fluffy/SprayWind/Arduino/WindSat2/schematic.pdf

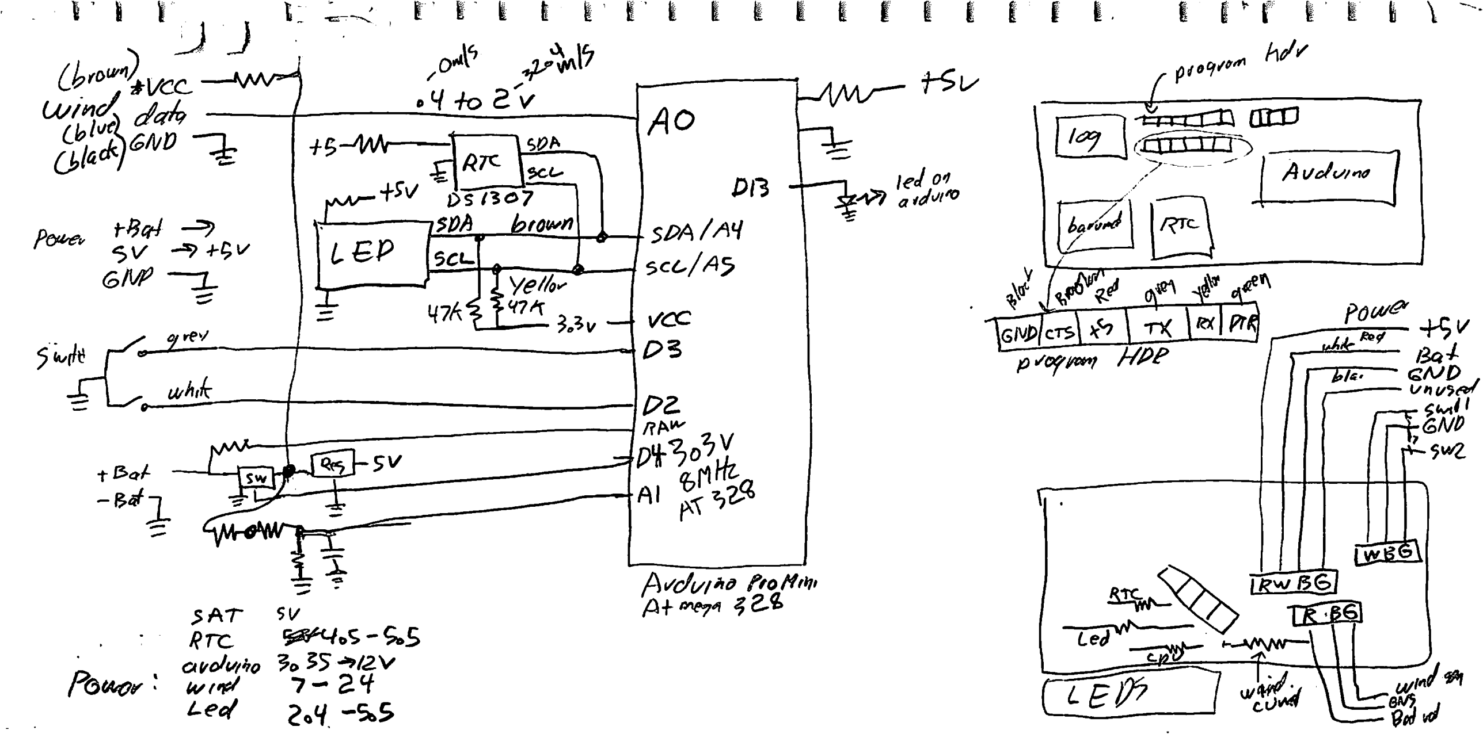
[picture p9: page 1]
