fluffy/SprayWind/doc/deploy.jpg

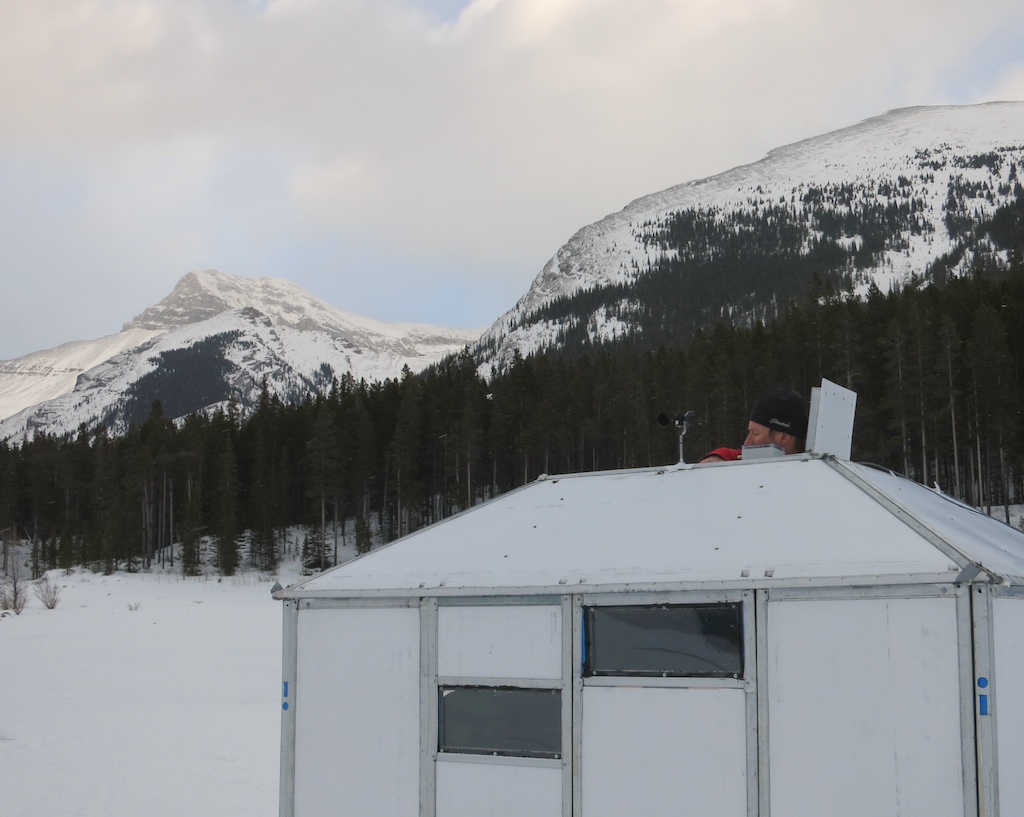
doc/deploy.jpg
