fluffy/SprayWind/wiring-notes.pdf

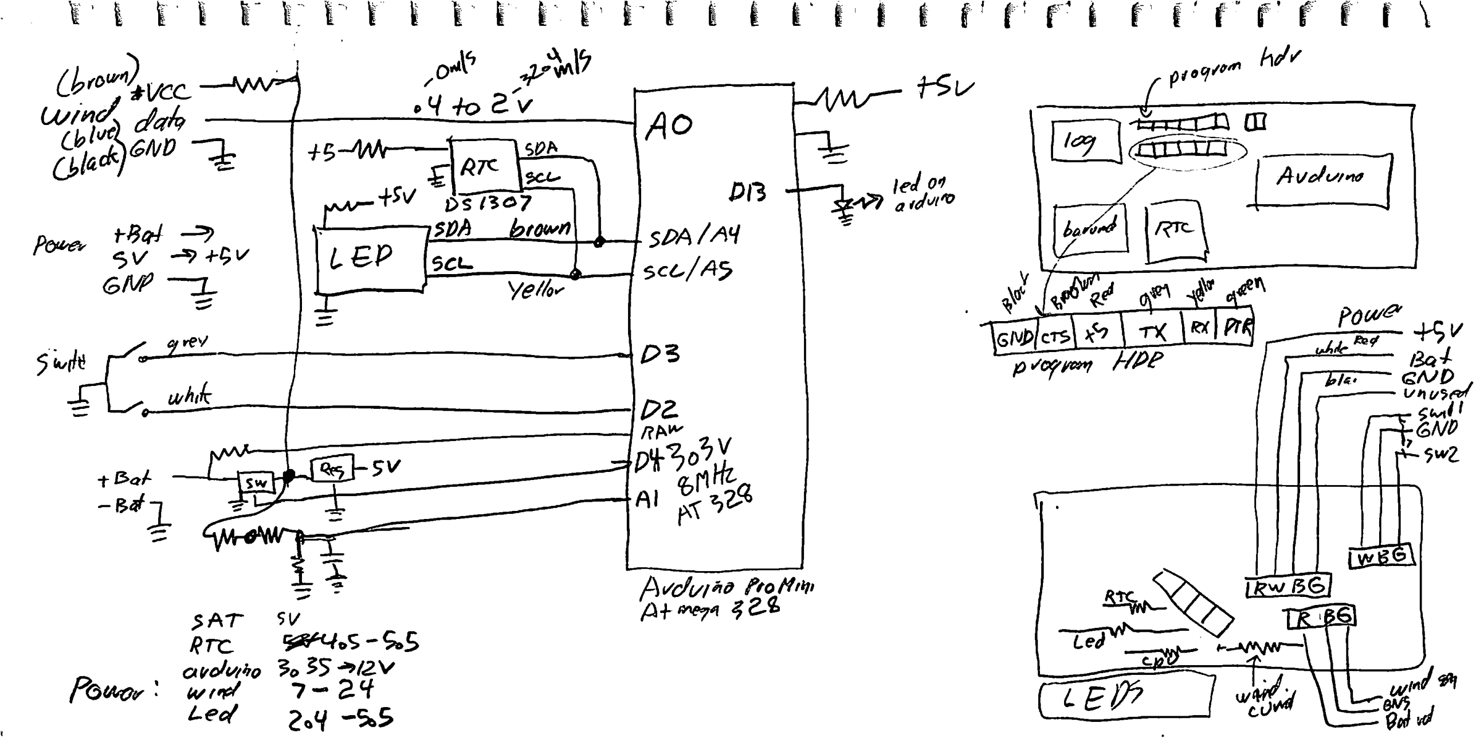
[picture p11: page 1]
