fluffy/SprayWind/website/testBody.txt

device_type=ROCKBLOCK&serial=8920&momsn=13&transmit_time=15-09-13+16%3A32%3A32&imei=300234063216600&iridium_latitude=51.0425&iridium_longitude=-114.0899&iridium_cep=5&data=7b22626e223a225242383932302f222c226275223a226d2f73222c2265223a5b7b226e223a2262617474657279222c2275223a2256222c2276223a342e337d2c7b226e223a2267757374222c2276223a31352e33347d2c7b226e223a2277696e64222c2276223a372e36377d5d7d
