fluffy/SprayWind/Arduino/WindSat/WindSat.ino

/* 
 Copyright (c) 2012, Cullen Jennings <fluffy@iii.ca> All rights reserved.
 
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
 1. Redistributions of source code must retain the above copyright notice, this
 list of conditions and the following disclaimer. 
 
 2. Redistributions in binary form must reproduce the above copyright notice,
 this list of conditions and the following disclaimer in the documentation
 and/or other materials provided with the distribution. 
 
 3. Neither the name of Cullen Jennings nor the names of its contributors may 
 be used to endorse or promote products derived from this software without 
 specific prior written permission.
 
 THIS SOFTWARE IS PROVIDED BY THE COPYRIGHT HOLDERS AND CONTRIBUTORS "AS IS" AND
 ANY EXPRESS OR IMPLIED WARRANTIES, INCLUDING,::w BUT NOT LIMITED TO, THE IMPLIED
 WARRANTIES OF MERCHANTABILITY AND FITNESS FOR A PARTICULAR PURPOSE ARE
 DISCLAIMED. IN NO EVENT SHALL THE COPYRIGHT OWNER OR CONTRIBUTORS BE LIABLE FOR
 ANY DIRECT, INDIRECT, INCIDENTAL, SPECIAL, EXEMPLARY, OR CONSEQUENTIAL DAMAGES
 (INCLUDING, BUT NOT LIMITED TO, PROCUREMENT OF SUBSTITUTE GOODS OR SERVICES;
 LOSS OF USE, DATA, OR PROFITS; OR BUSINESS INTERRUPTION) HOWEVER CAUSED AND
 ON ANY THEORY OF LIABILITY, WHETHER IN CONTRACT, STRICT LIABILITY, OR TORT
 (INCLUDING NEGLIGENCE OR OTHERWISE) ARISING IN ANY WAY OUT OF THE USE OF THIS
 SOFTWARE, EVEN IF ADVISED OF THE POSSIBILITY OF SUCH DAMAGE.
 
 
 Example program to connect up SPOT Connect to Arduino using the SparkFun Run SPOT Run board. 
 
 The source code repository for this project is at: https://github.com/fluffy/SprayWind 
 
 Using this Library:
 
 You have to set up a soft or hardware serial interface to the SPOT and it must be 115200 baud. 
 The SatConnect calss also takes the two pins to controll the power and on button to the Run SPOT Run board. 
 
 begin and end method turn the power on and off on the spot 
 write sends a message. It must be shorter than 41 bytes 
 
 you can use ready to find out when it is OK to do a write 
 
 you can use state to track the transmition of a message which takes aproximately 20 minutes 
 */

#include <Serial.h>
#define ONEWIRE_CRC16 0
#define ONEWIRE_CRC8_TABLE 0
#include <OneWire.h>

#define DEBUG( X ) Serial.println( X ); Serial2.println( X ); 
#define DEBUG_NOCR( X ) Serial.print( X ); Serial2.print( X ); 
#define DEBUG_NOCR2( X,Y ) Serial.print( X,Y );Serial2.print( X,Y ); 
#define DEBUG2( X, Y ) Serial.print( X ); Serial.println( Y ); Serial2.print( X ); Serial2.println( Y ); 

const int windPin = 2;     // the number of the wind speed pin - must be 2 for interupt 0 
const int batteryPin = 1;  // analog pin for battery voltage sense 
const int spotPowerPin = 6; /* PwrPin - turns on power to SPOT device */

const int spotOnPin = 7;  /* controlls the "on" button on the SPOT to turn the device on and off  */




// ========================================================================
// Stuff for Spot Connect Satellite code 

class SatConnect
{
public:
  SatConnect( Stream& pSerial, int pPwrPin, int pOnPin ); 

  enum SatConnectState 
  { 
    off,  poweringUp, readyToSend, haveMsgToSend, findingPostion, sending, sentOnce, sentTwice, errorNoGPS, errorNoSpot
  };

  bool ready();
  SatConnectState state();
  void begin();
  void end();

  void write( char* msg, int len );

private:
  const int pwrPin;
  const int onPin;
  Stream& serial;
  SatConnect::SatConnectState s; 
};


SatConnect::SatConnect( Stream& pSerial, int pPwrPin, int pOnPin ): 
serial(pSerial), pwrPin(pPwrPin), onPin(pOnPin)
{
  pinMode(pwrPin,OUTPUT);
  pinMode(onPin,OUTPUT);
  digitalWrite( pwrPin, LOW ); // turn off power to SPOT
  digitalWrite( pwrPin, HIGH ); // Leave button not pushed 
  s = SatConnect::off;
}


bool SatConnect::ready()
{
  if ( state() == SatConnect::readyToSend ) 
  {
    return true;
  }
  return false;
}


SatConnect::SatConnectState SatConnect::state()
{
  static unsigned long satLastTime=0;

  if ( s == SatConnect::off )
  {
    return s;
  }

#if 0  // can skip this and be more agresive about error recoevery
  if ( s == SatConnect::errorNoSpot )
  {
    return s;
  }
#endif

  unsigned long now =  millis();
  if ( now < satLastTime + 500 ) // if state if less than 500 ms old, don't check for new state 
  { 
    return s;
  }
  satLastTime = now;

  // flush out any old stuff in serial buffer   
  unsigned long lastTime = millis();
  uint8_t c;
  do
  {
    if ( serial.available() )
    {
      c = serial.read();
      lastTime = millis();
      DEBUG2("Flushing extra data: 0x", HEX ); 
    }
  } 
  while ( millis() < lastTime + 150 ); // no data for 150 ms 

  static uint8_t statReq[3] = {  
    0xAA, 0x03, 0x52                                             };
  serial.write( statReq, sizeof( statReq ) );

  lastTime = millis();
  uint8_t buf[ 0x30 ];
  buf[0] = 0;
  buf[1] = sizeof(buf);
  buf[7] = 0;
  buf[19]= 0;
  int i=0;
  do
  {
    if ( serial.available() )
    {
      buf[i++] = serial.read();
      lastTime = millis();
    }
    if (buf[0] != 0xAA) // keep reading until find the 0xAA start of message byte 
    {
      i=0;
    }
    if ( i == buf[1] )
    {
      //DEBUG( "Read full packet" );
      break;
    }
  } 
  while ( (millis() < lastTime + 150) && ( i < sizeof(buf) ) ); // 150 ms timeout after last char read 

  if ( (i != buf[1]) && (i+2 != buf[1]) ) // for some reason always getting 2 bytes short on some firware
  {
    int timeout = millis()-lastTime;
    DEBUG( "Problem reading packet buf" );
    DEBUG2( "buf[1]=", buf[1] );
    DEBUG2( "i=", i );
    DEBUG2( "time out=", timeout );
  }

#if 1
  //DEBUG2( "i= 0x" ); 
  //DEBUG( i , HEX );
  DEBUG_NOCR( "SPOT Status: " );
  for ( int j=0; j<i; j++ )
  {
    int v=buf[j];
    DEBUG_NOCR2(v/16, HEX);
    DEBUG_NOCR2(v%16, HEX);
    DEBUG_NOCR(" ");
  }
  DEBUG(" ");
#endif


  if ( buf[0] != 0xAA )
  {
    DEBUG("put in errorNoSpot in state() call" );
    s = SatConnect::errorNoSpot;
    return s;
  }

  DEBUG2( "spot status=" , buf[7] );
  DEBUG2( "gps found=" , buf[26] );
  DEBUG2( "num satellite=" , buf[31] );

  if ( buf[7] == 7 )
  {
    s = SatConnect::findingPostion;
  }

  if ( buf[7] == 15 )
  {
    s = SatConnect::sending;
  }

  if ( buf[7] == 6 )
  {
    s = SatConnect::sending;
    if ( buf[19] == 1 )
    {
      s = SatConnect::sentOnce;
    }
    if ( buf[19] == 2 )
    {
      s = SatConnect::sentTwice;
    }
  }

  // TODO - detect error no GPS 
  if ( buf[7] == 0 )
  {
    s = SatConnect::readyToSend;
  }

  return s;
}


void SatConnect::begin()
{
  s = SatConnect::off;
  //serial.begin( 115200 ); // TODO - move to here ?

  DEBUG( "Starting up spot" );
  pinMode(pwrPin,OUTPUT);
  pinMode(onPin,OUTPUT);
  digitalWrite( pwrPin, LOW ); // turn off power to SPOT
  digitalWrite( onPin, HIGH ); // release the ON button for SPOT  
  delay( 1500 /* don't know how long this should be */ ); // wait for total power off for reset (500 seemed too low)
  //DEBUG( "  about to turn on power to spot" );
  digitalWrite( pwrPin, HIGH ); // turn on power to SPOT
  //DEBUG( "  power is on" );
  delay( 750 /* don't know how long this should be */ ); // wait for power to get stable 
  //DEBUG( "  turing on " );
  digitalWrite( onPin, LOW ); // press the ON button to power up SPOT
  delay( 4100 /* TODO - how long */ ); // wait for turn on and go into discovery mode TOOD - check if really need to go bluetooth discovery mode 
  //DEBUG( "  waiting to go on " );
  digitalWrite( onPin, HIGH ); // release the ON button for SPOT - it is still on 
  DEBUG( "   spot is on" );

  //unsigned long  startTime = millis();
  //unsigned long  charTime = millis();

  DEBUG( "Wait for SPOT self check and flush serial data" );
  DEBUG_NOCR( "Flush: " );
  unsigned long lastTime = millis();
  do
  {
    uint8_t c;
    if ( serial.available() )
    {
      c = serial.read();
      //charTime = millis();

      int v=c;
      DEBUG_NOCR2(v/16, HEX);
      DEBUG_NOCR2(v%16, HEX);
      DEBUG_NOCR(" ");
    }
  } 
  while ( millis() < lastTime+3000 ); // flush for at least 2.5 seconds 
  DEBUG( "  done flushing" );

  //DEBUG2( "flush time was " , charTime - startTime );

  s = SatConnect::poweringUp;   
}


void SatConnect::end()
{
  if ( s ==  SatConnect::off )
  {
    digitalWrite( pwrPin, LOW ); // turn off the power to SPOT
    delay( 1000 ); // make power stays off of a bit 
    return;  
  }

  DEBUG( "Shuting down spot" );
  digitalWrite( onPin, LOW ); // press the ON button to power off SPOT
  delay( 2200  );   // 1500 too short 
  DEBUG( "  waiting to go off " );
  digitalWrite( onPin, HIGH ); // release the ON button for SPOT - should be off now  
  delay( 1500 /* TODO - how long */ );   
  digitalWrite( pwrPin, LOW ); // turn off the power to SPOT
  delay( 1000 ); // make power stays off of a bit 

  s = SatConnect::off;
  DEBUG( "   spot is off" );
}


void  SatConnect::write( char* msg, int len )
{
  if ( state() == SatConnect::off ) 
  {
    begin(); // if not powered on, turn it on 
  }

  do 
  { 
    // wait until ready to send
  } 
  while ( !ready() );

  if ( len > 41 ) // TODO - figure out max len 
  {
    len = 41; 
  }

  // send message to SPOT 
  serial.flush();
  static uint8_t sendReq[8] = { 
    0xAA, 0x08, 0x26, 0x01, 0x00, 0x01, 0x00, 0x01                                             };
  sendReq[1] = sizeof(sendReq) + len; // set the length of the message 
  serial.write( sendReq, sizeof( sendReq ) );
  serial.write( (uint8_t*)msg, len );

  unsigned long lastTime = millis();
  uint8_t buf[ 0x30 ];
  buf[0] = 0;
  buf[1] = sizeof(buf);
  int i=0;
  do
  {
    if ( serial.available() )
    {
      buf[i++] = serial.read();
    }
    if ( i == buf[1] )
    {
      //DEBUG( "Read full packet" );
      break;
    }
  } 
  while ( (millis() < lastTime + 500) && ( i < sizeof(buf) ) ); // 500 ms timeout after reqest sent 

  if ( i != buf[1] )
  {
    int timeout = millis()-lastTime;
    DEBUG( "Problem reading packet buf after write" );
    DEBUG2( "buf[1]=", buf[1] );
    DEBUG2( "i=", i );
    DEBUG2( "time out=", timeout );
  }

#if 1
  //DEBUG2( "i=" , i );
  DEBUG_NOCR( "SPOT data after write: " );
  for ( int j=0; j<i; j++ )
  {
    int v=buf[j];
    DEBUG_NOCR2(v/16, HEX);
    DEBUG_NOCR2(v%16, HEX);
    DEBUG_NOCR(" ");
  }
  DEBUG(" ");
#endif

  s = SatConnect::haveMsgToSend;
}


SatConnect satConnect( Serial3, spotPowerPin, spotOnPin ); 

// =================================================================
// stuff for wind 

volatile unsigned long windCount; // count of revolutions of wind sensor 
unsigned long windStartTime;
unsigned long windPrevTime;
unsigned long windStartCount;
unsigned long windPrevCount;
unsigned int  minMetersPer10s=0;
unsigned int  curMetersPer10s=0;
unsigned int  maxMetersPer10s=0;
unsigned int  avgMetersPer10s=0;


void incWindCount()
{
  // this is the itnerupt handler and interupts are disabled in it
  windCount++; 
}


unsigned long getWindCount()
{
  unsigned long r;
  noInterrupts(); // disable interupts while copying the counter 
  r = windCount;
  interrupts();
  return r; 
}


void resetWind()
{
  unsigned long time = millis();
  unsigned long count = getWindCount();

  windStartTime = time;
  windPrevTime = time;
  windStartCount = count;
  windPrevCount = count; 

  minMetersPer10s = 0xFFFF;
  maxMetersPer10s = 0;
}


void updateWind()
{
  unsigned long time = millis();

  if ( time < windPrevTime + 10000 ) // wait at least 10 seconds
  {
    return;
  }
  unsigned long count = getWindCount();

  unsigned long dTime = time - windPrevTime;
  unsigned long dCount = count - windPrevCount;
  unsigned long dMeters = (int)dCount + ( (int)dCount / 8 ); // sketchy conversion that looks about right 
  curMetersPer10s = dMeters * 10000 / (int)dTime ;  // 10000 is 10 secons and 1000 to move time from ms to s

  if ( curMetersPer10s > maxMetersPer10s ) maxMetersPer10s = curMetersPer10s;
  if ( curMetersPer10s < minMetersPer10s ) minMetersPer10s = curMetersPer10s;

  //DEBUG2( "dTime = " , dTime );

  //DEBUG2( "dCount = " , dCount );

  //DEBUG2( "Current = " , curMetersPer10s );

  dTime = (time - windStartTime) / 100; // in 10th of seconds 
  dCount = count - windStartCount;
  unsigned long avgCountPer10s =  dCount*100 / dTime; // 100 is 10 for per 10 seconds , and 10 for time is in 10ths of seconds
  avgMetersPer10s = (int)avgCountPer10s + ( (int)avgCountPer10s / 8 ); // sketchy conversion that looks about right 

  //DEBUG2( "Avg = " ); 
  //DEBUG( avgMetersPer10s );

  windPrevTime = time;
  windPrevCount = count;
}


//===============================================================================
// Stuff for battery 

unsigned int voltageX100=0;

void updateBattery()
{
  int v = analogRead( batteryPin ); // 0-5 v scaled to 0-1023 

  //voltageX100 = 80 + v + (v>>1) + (v>>5); // this is when power goes thgrough diode 
  voltageX100 = v + (v>>1) + (v>>5); 
}


// ===============================================================================
// Stuff for temperature   

int          tempatureX10=0; 
typedef uint8_t DeviceAddr[8];
DeviceAddr tempatureAddr;
char tempatureType='-';
OneWire  oneWireBus(10); // using digiital IO on pin 10


void copyAddr( uint8_t src[], uint8_t dst[] )
{
  for( int i=0; i<8; i++ )
  {
    dst[i]=src[i];
  }
}

// #define FAST_TEMP_CONV

void setupTemp()
{
  tempatureX10 = 0;

  DEBUG("Scanning 1-wire Bus A ...");
  DeviceAddr addr;
  oneWireBus.reset_search();
  while ( oneWireBus.search(addr) )
  {
    if ( OneWire::crc8( addr, 7) != addr[7]) 
    {
      DEBUG("1-Wire BAD-CRC2");
    }
    else
    {
      if ( addr[0] == 0x10 ) 
      {
        DEBUG("Found DS18S20 Temperature on bus A");
        copyAddr( addr, tempatureAddr);   
        tempatureType = 'S';   
      }
      else if ( addr[0] == 0x28 ) 
      {
        DEBUG("Found DS18B20 Temperature on bus A");
        copyAddr( addr, tempatureAddr);   
        tempatureType = 'B';   
      }
      else
      {
        DEBUG2("Found 1-wire device of unknown address type: ",  addr[0] );
      }
    }
  }

  if ( tempatureType == 'B' )
  {
    // program for fast or slow conversions 
    oneWireBus.reset();
    oneWireBus.select(tempatureAddr);
    oneWireBus.write(0x4E,1);  // Program config register
    oneWireBus.write(0x0,1);
    oneWireBus.write(0x0,1);
#ifdef  FAST_TEMP_CONV
    oneWireBus.write(0x1F,1);
#else
    oneWireBus.write(0x7F,1);
#endif
  }

}


void updateTemp( )
{
  oneWireBus.reset();
  oneWireBus.select(tempatureAddr);
  oneWireBus.write(0x44,1);  // do conversion 

  if (tempatureType =='B' )
  {
#ifdef FAST_TEMP_CONV
    delay(100);
#else
    delay(800);  // at least 750 ms for conversion time   
#endif
  }
  else
  {
    delay(800);  // at least 750 ms for conversion time   
  }
  oneWireBus.reset();
  oneWireBus.select(tempatureAddr);    
  oneWireBus.write(0xBE);  // read results

  byte data[9];
  for ( int i = 0; i < 9; i++) 
  {          
    data[i] = oneWireBus.read();
  }
  if ( OneWire::crc8( data, 8) != data[8] )
  {
    DEBUG("Tempature BAD-CRC");
    tempatureX10 = 0;
    return ; 
  }

  int tempatureX100 =0;
  tempatureX10 =0;

  if (tempatureType =='B' )
  {
    //DEBUG_NOCR( "config reg = 0x" );
    //DEBUG_NOCR2( data[4],HEX );
    //DEBUG(" ");
#ifdef   FAST_TEMP_CONV
    data[0] = data[0] & 0xF8;
#endif

    int temp16x = (data[1]<<8) + data[0];    
    tempatureX100 = (temp16x*25) / 4; 
    tempatureX10 = (temp16x*5) / 8;
  }
  else if (tempatureType =='S' )
  {
    int temp2x = (data[1]<<8) + data[0];    
    //DEBUG2( "count remain = " , data[6] );
    int temp16x = ( temp2x & 0xFFFE )*8 - 4 + 16 - data[6];

    tempatureX100 = (temp16x*25) / 4; 
    tempatureX10 = temp16x * 5 / 8;
  }

  //DEBUG_NOCR( "Temp data = 0x" );
  //DEBUG_NOCR2( data[1], HEX );
  //DEBUG_NOCR( " " );
  //DEBUG_NOCR2( data[0], HEX );
  DEBUG2( " Got tempature 10x = " , tempatureX10 );

  //DEBUG2( " Got tempature 100x = " , tempatureX100 );
}


// ========================================================================
// stuff to form the output JSON sent over SPOT 

char  outputVector[41];
void formatOutputVector()
{
  int i=0;
  outputVector[i++] = '{';
  outputVector[i++] = '"';
  outputVector[i++] = 'v';
  outputVector[i++] = '"';
  outputVector[i++] = ':';
  outputVector[i++] = '[';

  outputVector[i++] = '0' + (curMetersPer10s/100)%10;
  if  (outputVector[i-1] == '0' ) outputVector[i-1]=' ';
  outputVector[i++] = '0' + (curMetersPer10s/10 )%10;
  outputVector[i++] = '.';
  outputVector[i++] = '0' + (curMetersPer10s    )%10;
  outputVector[i++] = ',';

  outputVector[i++] = '0' + (minMetersPer10s/100)%10;
  if  (outputVector[i-1] == '0' ) outputVector[i-1]=' ';
  outputVector[i++] = '0' + (minMetersPer10s/10 )%10;
  outputVector[i++] = '.';
  outputVector[i++] = '0' + (minMetersPer10s    )%10;
  outputVector[i++] = ',';

  outputVector[i++] = '0' + (avgMetersPer10s/100)%10;
  if  (outputVector[i-1] == '0' ) outputVector[i-1]=' ';
  outputVector[i++] = '0' + (avgMetersPer10s/10 )%10;
  outputVector[i++] = '.';
  outputVector[i++] = '0' + (avgMetersPer10s    )%10;
  outputVector[i++] = ',';

  outputVector[i++] = '0' + (maxMetersPer10s/100)%10;
  if  (outputVector[i-1] == '0' ) outputVector[i-1]=' ';
  outputVector[i++] = '0' + (maxMetersPer10s/10 )%10;
  outputVector[i++] = '.';
  outputVector[i++] = '0' + (maxMetersPer10s    )%10;
  outputVector[i++] = ',';

  // output tempature in degC  
  int v = (tempatureX10>=0) ? tempatureX10 : -tempatureX10;
  outputVector[i++] = (tempatureX10>0) ? ' ' : '-';
  outputVector[i++] = '0' + (v/100)%10;
  if  (outputVector[i-1] == '0' ) 
  {
    outputVector[i-1]= (tempatureX10>=0) ? ' ' : '-';
    outputVector[i-2]= ' ';
  }
  outputVector[i++] = '0' + (v/10 )%10;
  outputVector[i++] = '.';
  outputVector[i++] = '0' + (v    )%10;
  outputVector[i++] = ',';

  // output battery voltage voltageX100
  outputVector[i++] = '0' + (voltageX100/1000)%10;
  if  (outputVector[i-1] == '0' ) outputVector[i-1]=' ';
  outputVector[i++] = '0' + (voltageX100/100  )%10;
  outputVector[i++] = '.';
  outputVector[i++] = '0' + (voltageX100/10   )%10;
  outputVector[i++] = '0' + (voltageX100      )%10;
  //outputVector[i++] = ',';

  outputVector[i++] = ']';
  outputVector[i++] = '}';
  outputVector[i++] = 0;
  if (i >= sizeof(outputVector) )
  {
    DEBUG("buffer overlow in format output vector");
    DEBUG2( "i=" , i );
    while (1);
  }
}



//=====================================================================
// main program part 

void setup()
{
  Serial.begin(19200); 
  Serial2.begin(19200); 
  Serial3.begin(115200); // important - don't forget to setup the serial connection speed to the spot 

  delay( 1500 ); 
  DEBUG("Starting program - Version 0.1.2");

  // setup wind 
  pinMode(windPin, INPUT);
  windCount = 0;
  attachInterrupt(0, incWindCount, RISING); // int 0 is digital pin 2 
  resetWind();

  // set up battery 
  analogReference( DEFAULT );

  // set up temperature on oneWire 
  setupTemp();
}


void loop()
{
  static bool sendNow = true;
  static unsigned long prevLoopTime=0;
  static unsigned long satOnTime=0;
  unsigned long thisLoopTime=0;

  thisLoopTime = millis();

  unsigned long thisHour = prevLoopTime / 3600000;
  unsigned long prevHour = thisLoopTime / 3600000;

  // every hour, send a new report
  if ( thisHour != prevHour )
  {
    sendNow = true; 
  }

#if 0  // don't do this and try and receover from error  
  // if the spot has and error, shut it down 
  if ( satConnect.state() == SatConnect::errorNoSpot )
  {
    DEBUG( "turned off sat due to error" );
    satConnect.end(); // turn power to spot off 
    sendNow = false; // if msg to be sent, wait till next hour
  }
#endif 

  // if sat has been on for more than 30 minutes, turn it offf 
  if ( (satConnect.state() != SatConnect::off) && ( thisLoopTime > satOnTime+1800000 ) ) 
  {
    DEBUG( "turned off sat due to being on too long" );
    satConnect.end(); // turn power to spot off 
    sendNow = false; // if msg to be sent, wait till next hour
  }

#if 0
  sendNow = false;
#endif

  // if message to send,
  if (sendNow)
  {
    if (  millis() > 30000  )  // if message to send, and arduino has been up for at least 30 seconds, turn on the spot
    {
      if ( satConnect.state() == SatConnect::off  )
      {
        DEBUG( "turned on sat because have messages to send" );
        satConnect.begin(); // turn spot power on
        satOnTime = millis();
      }
    }
  }

  if (sendNow)
  {
    if ( satConnect.ready()  )
    {
      updateBattery();
      updateTemp();
      updateWind();

      formatOutputVector();

      resetWind();

      DEBUG2("Sending Message len=", strlen(outputVector) ); 
      DEBUG2("msg=", outputVector );

      satConnect.write( outputVector, strlen(outputVector) );
      sendNow = false;
    }
  }

#if 0 // TODO remove 
  if ( sendNow == false )
  { 
    if ( satConnect.state() == SatConnect::sentTwice)
    {
      DEBUG( "Turning off sat because have sent the message once" );
      satConnect.end(); // turn power to spot off 
      sendNow = true;
    }
  }
#endif  

  if ( sendNow == false )
  { 
    if ( satConnect.ready() )
    {
      DEBUG( "Turning off sat because done sending messages" );
      satConnect.end(); // turn power to spot off 
    }
  }

#if 1
  unsigned long thisFifteenSec = prevLoopTime / 15000;
  unsigned long prevFifteenSec = thisLoopTime / 15000;
  if ( thisFifteenSec != prevFifteenSec ) // print out status ever 15 seconds 
  {
    int state = int( satConnect.state() );
    unsigned long time =  millis();

    DEBUG_NOCR( "Time " );
    DEBUG_NOCR( time );
    DEBUG_NOCR( ": " );
    switch ( state )
    {
      case SatConnect::off:      
      {  
        DEBUG( "Spot connect is off" ); 
        break;
      }
      case SatConnect::poweringUp:      
      {  
        DEBUG( "Spot connect is poweringUp" ); 
        break;
      }
      case SatConnect::readyToSend:      
      {  
        DEBUG( "Spot connect is readyToSend" ); 
        break;
      }
      case SatConnect::haveMsgToSend:      
      {  
        DEBUG( "Spot has msg ready to send" ); 
        break;
      }
      case SatConnect::findingPostion:      
      {  
        DEBUG( "Spot connect is findingPostion" ); 
        break;
      }
      case SatConnect::sending:      
      {  
        DEBUG( "Spot connect is sending" ); 
        break;
      }
      case SatConnect::sentOnce:      
      {  
        DEBUG( "Spot connect is sentOnce" ); 
        break;
      }
      case SatConnect::sentTwice:      
      {  
        DEBUG( "Spot connect is sentTwice" ); 
        break;
      }
      case SatConnect::errorNoGPS:      
      {  
        DEBUG( "Spot connect has error No GPS signal" ); 
        break;
      }
      case SatConnect::errorNoSpot:      
      {  
        DEBUG( "Spot connect has error No Spot device" ); 
        break;
      }
    }
  }
#endif 

  updateWind();

#if 0 // print out tempature ever 15 seconds 
  unsigned long thisQuaterMin = prevLoopTime / 15000;
  unsigned long prevQuarterMin = thisLoopTime / 15000;
  if ( thisQuaterMin != prevQuarterMin )
  {
    updateTemp(); // does calling this too often warms up the sensor resulting in bogus measurements ?
  }
#endif

#if 1 // print out current conditions ever 5 minutes 
  unsigned long thisFiveMin = prevLoopTime / 300000;
  unsigned long prevFiveMin = thisLoopTime / 300000;
  if ( thisFiveMin != prevFiveMin )
  {
    updateBattery();
    updateTemp(); // does calling this too often warms up the sensor resulting in bogus measurements ?

    formatOutputVector();

    DEBUG_NOCR("Time = "); 
    DEBUG( millis()/1000 );
    DEBUG_NOCR("  Status = "); 
    DEBUG( outputVector );
  }
#endif

  delay( 1500 ); 

  prevLoopTime = thisLoopTime;
}
