fluffy/SprayWind/(commit log)

2012-12-24 added bases of arduino code
2012-12-24 add debug info - 2nd tx not working
    [WindSat.ino]
2012-12-24 fixed nasty bug in end
    [WindSat.ino]
2012-12-28 fixed battery voltage sense now that it does not go through diode
    [WindSat.ino]
2012-12-28 update that need one wire lib
2012-12-30 updated to new frimware on device
2012-12-31 updated for new power supply
2013-01-05 add some debug logs
    [CONFIG.TXT]
2013-01-08 fix voltage text
2013-01-08 changed to knot
2015-08-31 start new board
2015-09-06 start stuff for power control
2015-09-07 add sketch of wires
2015-09-20 basic power managment going
2015-09-20 power down mode
2015-09-21 fix formmating bug on print out
    [WindSat2.ino]
2015-10-03 update schematic
2015-10-03 put in delay for reading battery voltage
